pajrigithub/Tugas-Akhir/Test_Sensor/Ph2.jpeg

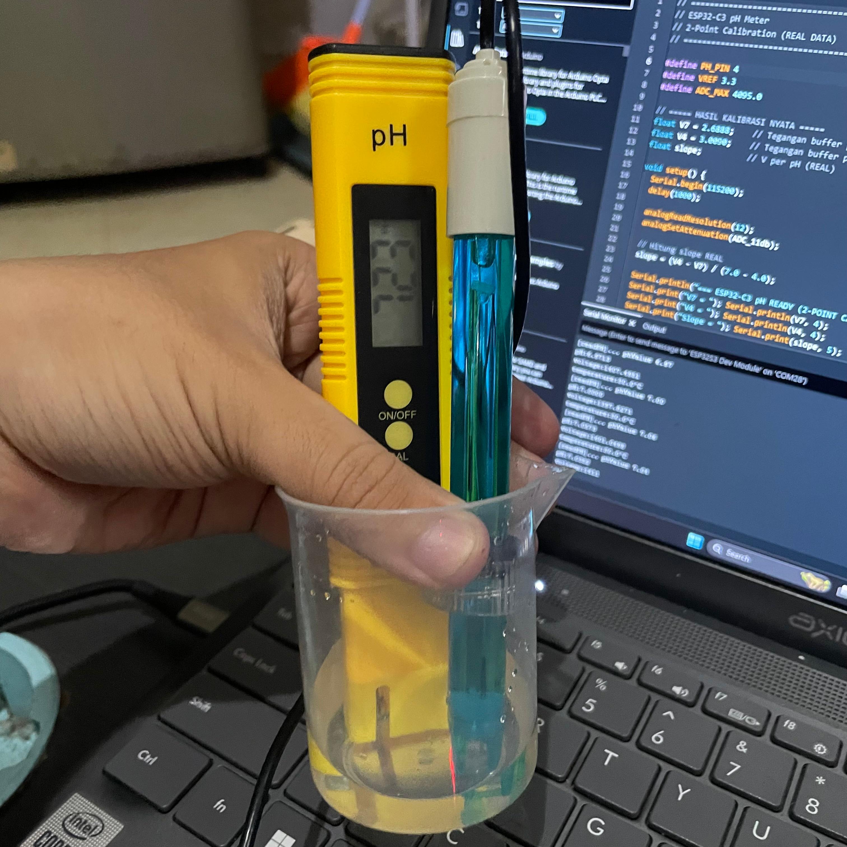
Test_Sensor/Ph2.jpeg
