pajrigithub/Tugas-Akhir/Test_Sensor/suhu3.jpeg

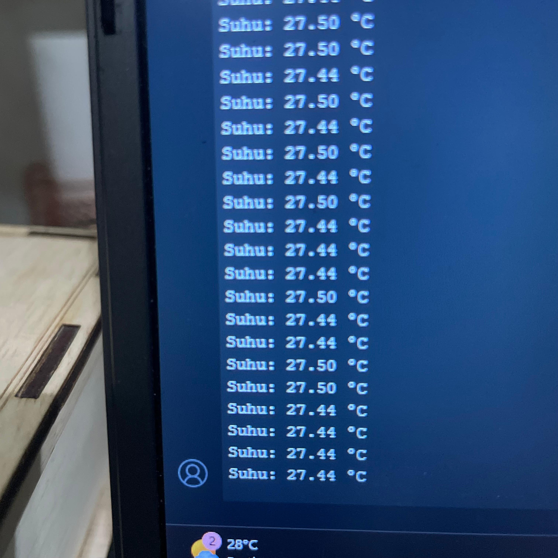
Test_Sensor/suhu3.jpeg
