pajrigithub/Tugas-Akhir/README.md

# 📘 TUGAS AKHIR

## 🧪 Rancang Bangun Sistem Kontrol Likuefaksi–Sakarifikasi Bioetanol Pati Singkong Berbasis ESP32

---

## 📌 Deskripsi Singkat
Penelitian ini berfokus pada perancangan dan implementasi **sistem kontrol proses likuefaksi dan sakarifikasi bioetanol berbahan baku pati singkong** menggunakan **ESP32 dan Raspberry pi 4** sebagai pengendali utama.  
Sistem dirancang untuk memonitor dan mengontrol parameter proses secara otomatis guna meningkatkan kestabilan, efisiensi, dan akurasi proses produksi bioetanol.
