pajrigithub/Tugas-Akhir/Dokumen/Teknis/Dokumen_teknis.md

# 📘 Dokumentasi Teknis Tugas Akhir

---

## 📌 Dokumen Utama
Dokumentasi lengkap Tugas Akhir pengujian komponen dan solusi dapat diakses melalui Google Docs berikut:

🔗 **Dokumen Tugas Akhir (Teknis & Pengujian):**  
https://docs.google.com/document/d/1LPt0MVdCAVRt8IWONAKQBSv0_9ESJtGt28g9HDy5lLI/edit?tab=t.0
