pajrigithub/Tugas-Akhir/Test_Sensor/pH3.jpeg

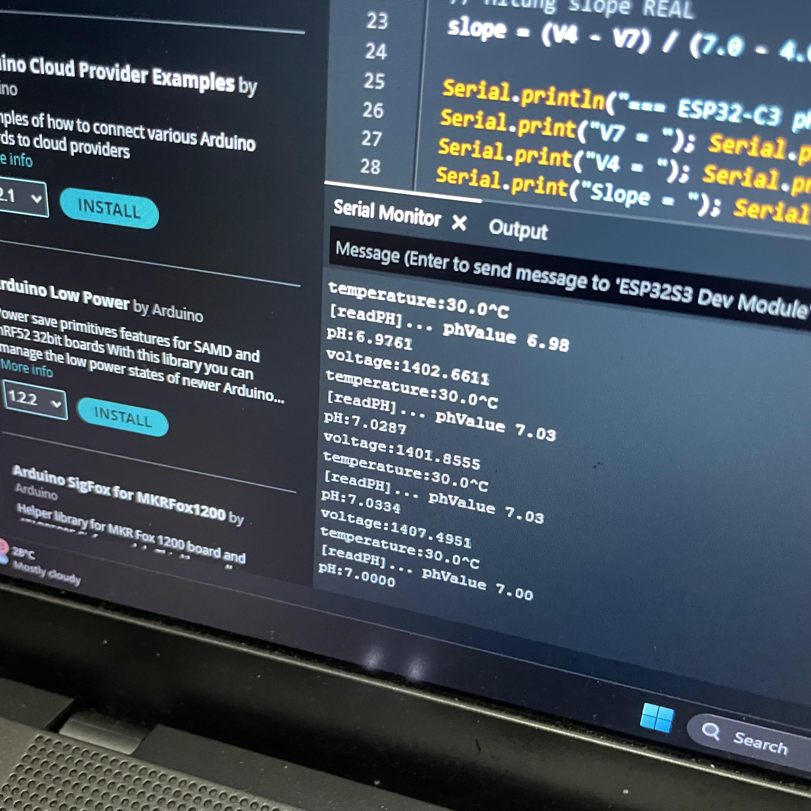
Test_Sensor/pH3.jpeg
