pajrigithub/Tugas-Akhir/Test_Sensor/pH.jpeg

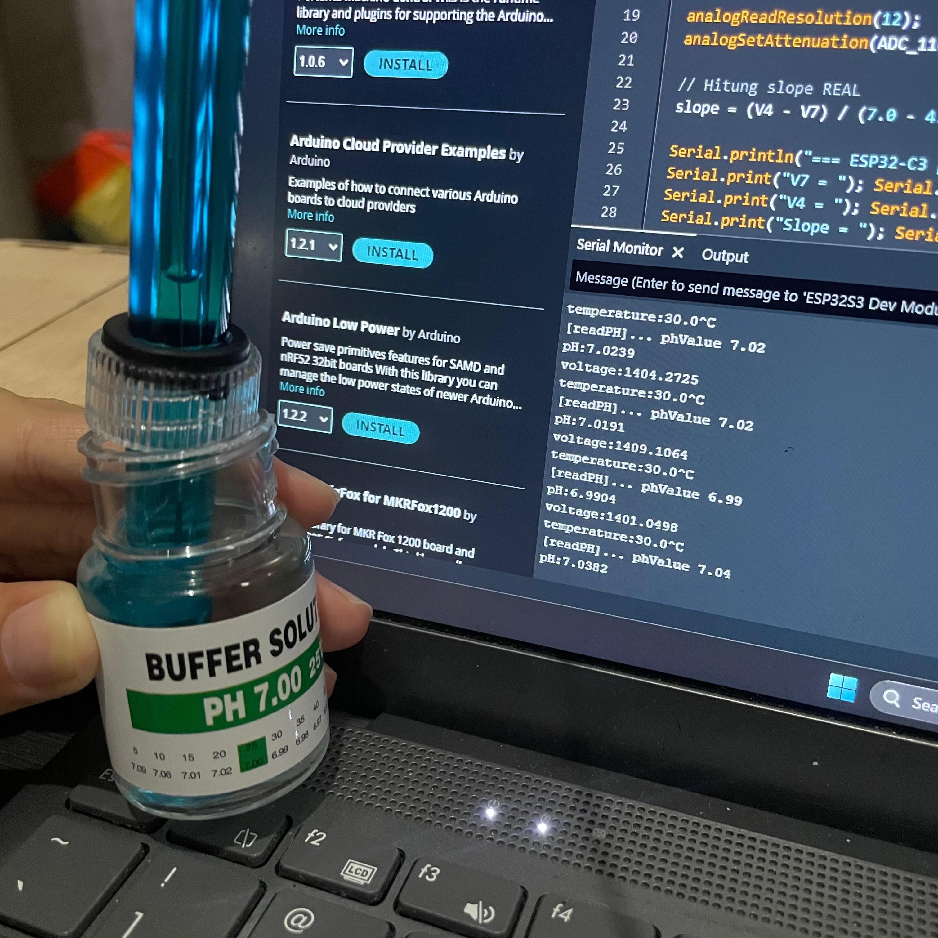
Test_Sensor/pH.jpeg
