pajrigithub/Tugas-Akhir/Test_Sensor/suhu 2.jpeg

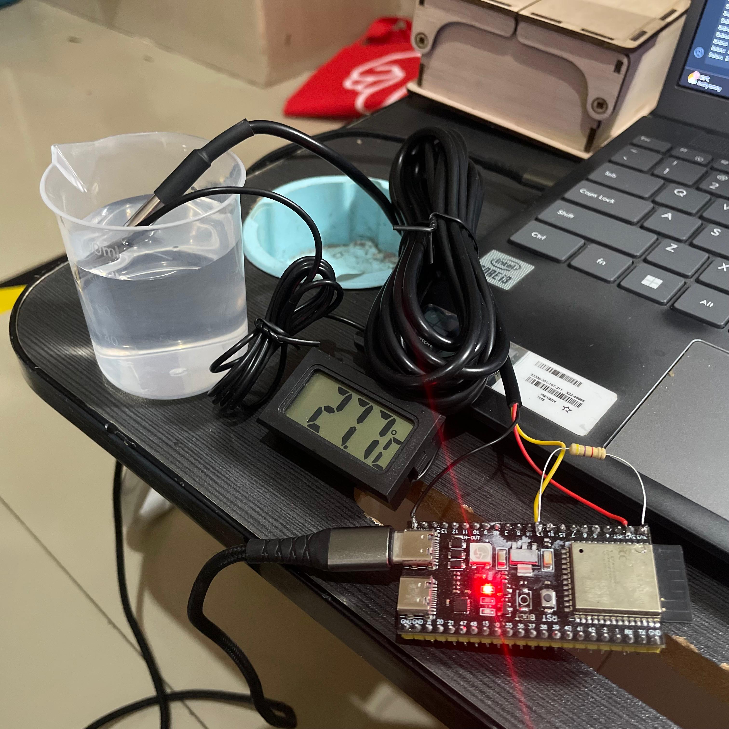
Test_Sensor/suhu 2.jpeg
