pajrigithub/Tugas-Akhir/Test_Sensor/suhu.jpeg

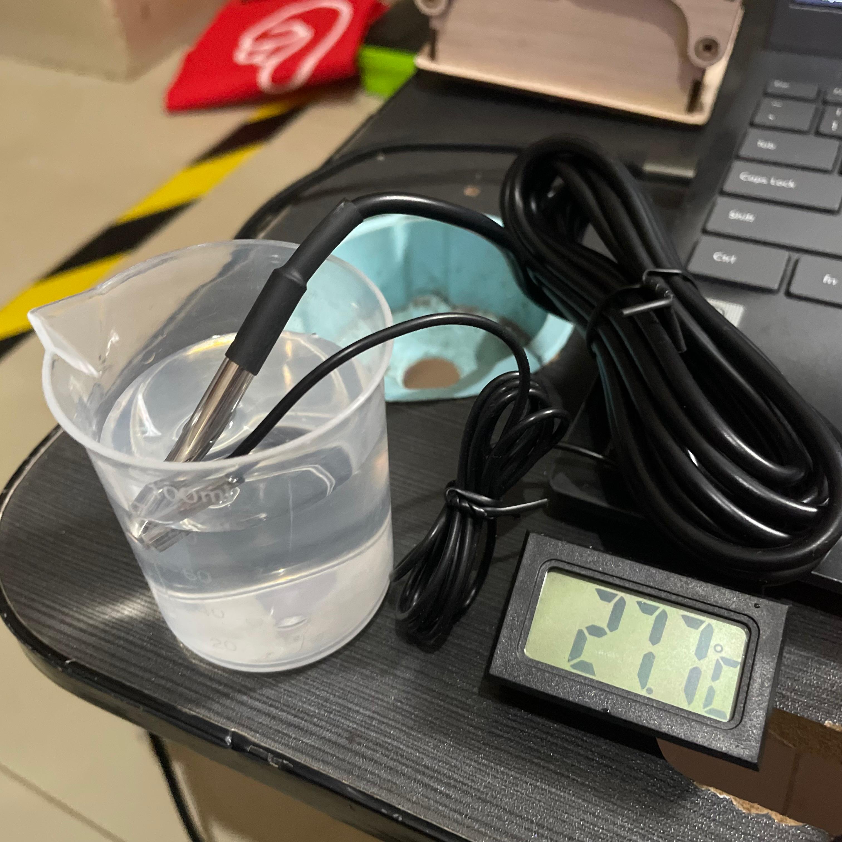
Test_Sensor/suhu.jpeg
